Jason-sketch729/Janus-Controller-master/Images/JC20.01-Features.PNG

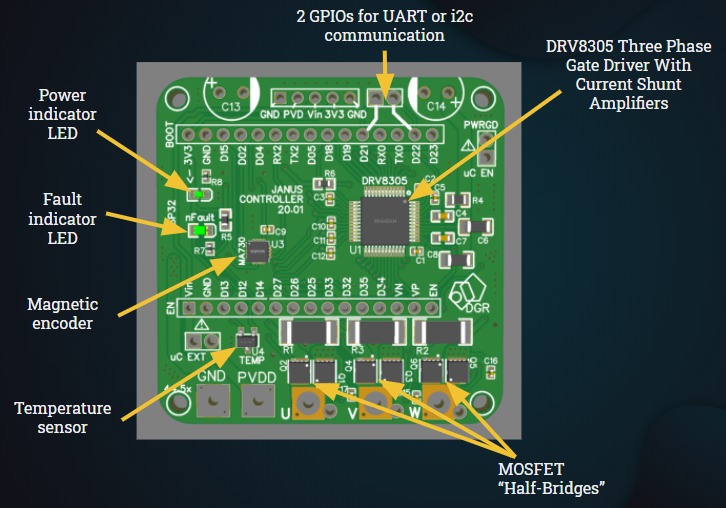
Images/JC20.01-Features.PNG
