Jason-sketch729/Janus-Controller-master/Images/AMT103.PNG

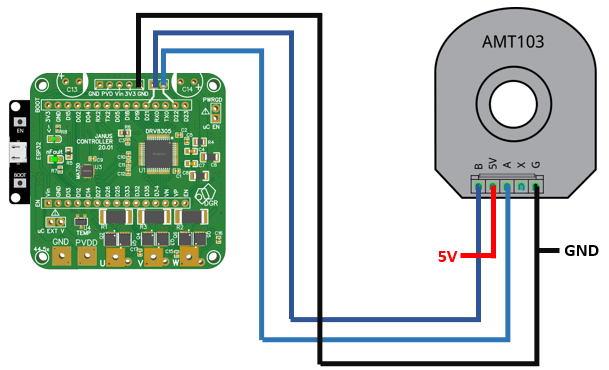
Images/AMT103.PNG
