Jason-sketch729/Janus-Controller-master/Images/BigJ-GIF.gif

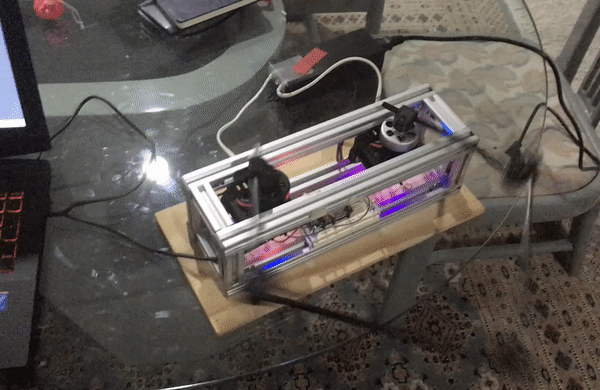
Images/BigJ-GIF.gif
