Jason-sketch729/Janus-Controller-master/Images/BigJ-iso.jpg

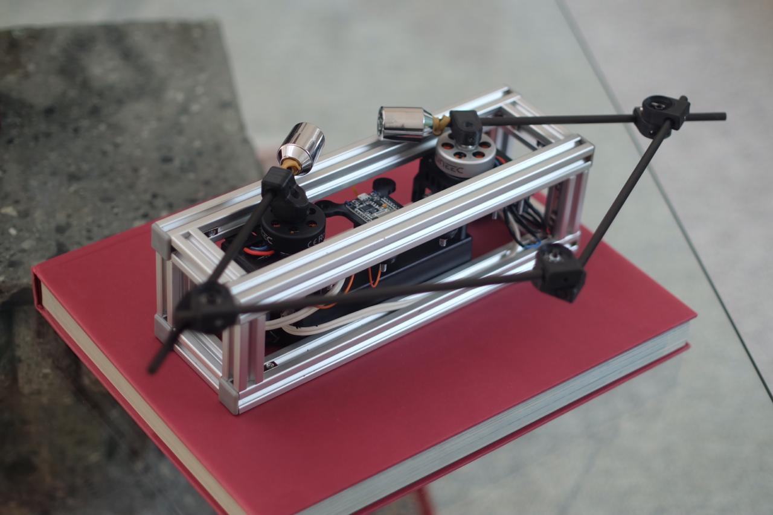
Images/BigJ-iso.jpg
