Jason-sketch729/Janus-Controller-master/Images/DRV8305Schematic.PNG

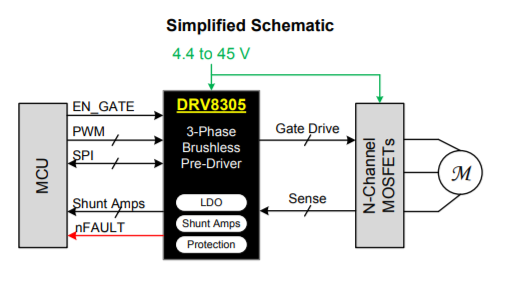
Images/DRV8305Schematic.PNG
