Jason-sketch729/Janus-Controller-master/Images/JC20.02.png

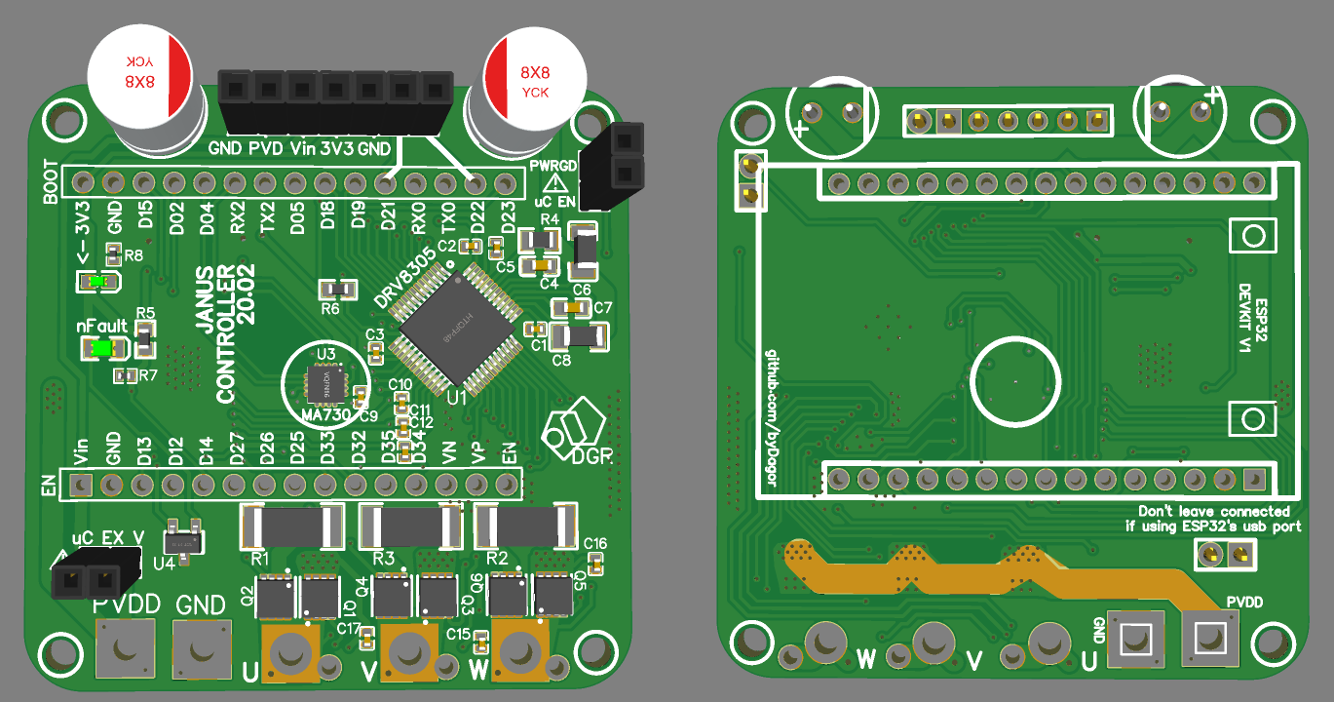
Images/JC20.02.png
