Jason-sketch729/Janus-Controller-master/Images/JCprep.PNG

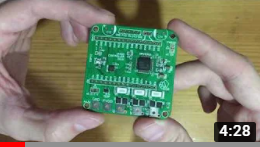
Images/JCprep.PNG
