Jason-sketch729/Janus-Controller-master/Images/LibraryManager.PNG

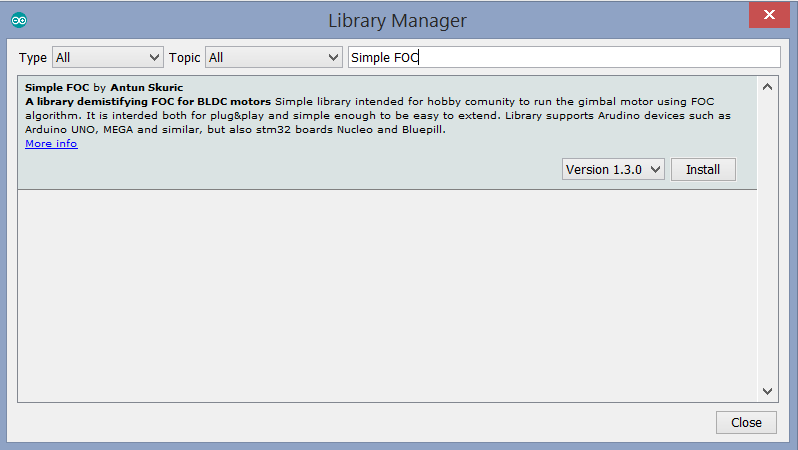
Images/LibraryManager.PNG
