Jason-sketch729/Janus-Controller-master/Images/MA730Magnet.PNG

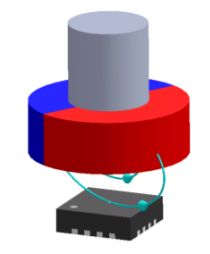
Images/MA730Magnet.PNG
