Jason-sketch729/Janus-Controller-master/JC20.01/Images/Back20.01.JPG

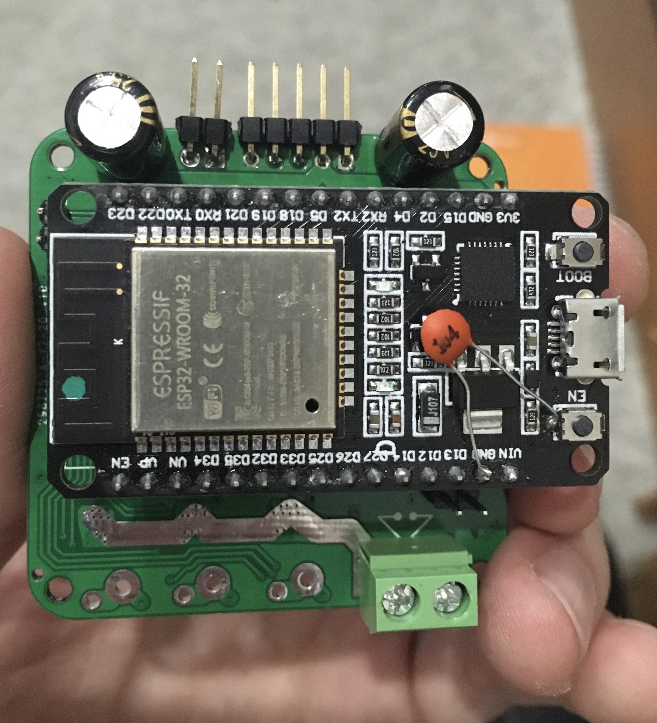
JC20.01/Images/Back20.01.JPG
