Jason-sketch729/Janus-Controller-master/JC20.01/Images/RenderFront20.01.PNG

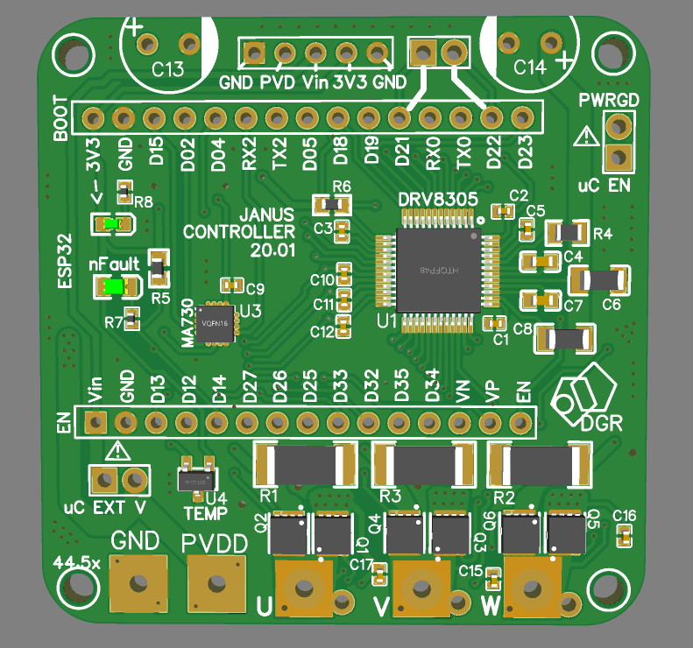
JC20.01/Images/RenderFront20.01.PNG
