Jason-sketch729/Janus-Controller-master/JC20.01/Schematics/JanusController20.01_Schematics.png

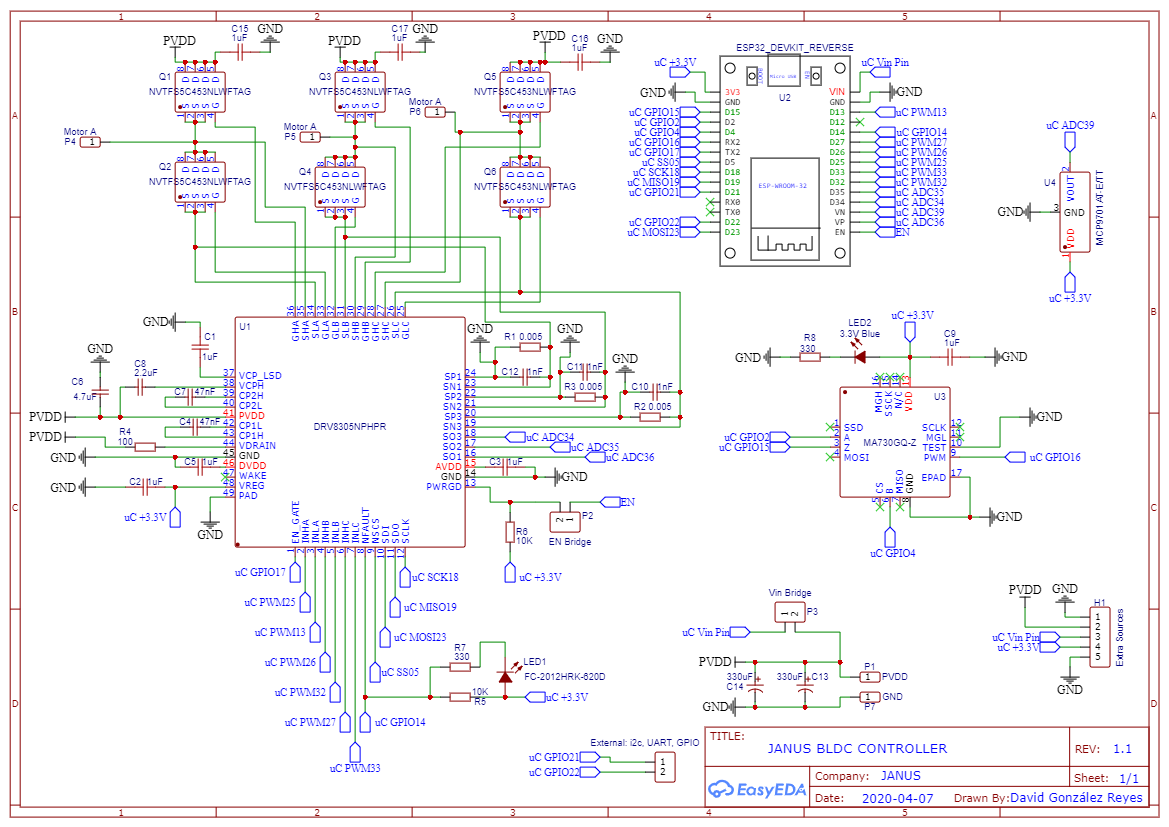
JC20.01/Schematics/JanusController20.01_Schematics.png
