Jason-sketch729/Janus-Controller-master/JC20.02/Images/JC20.02.png

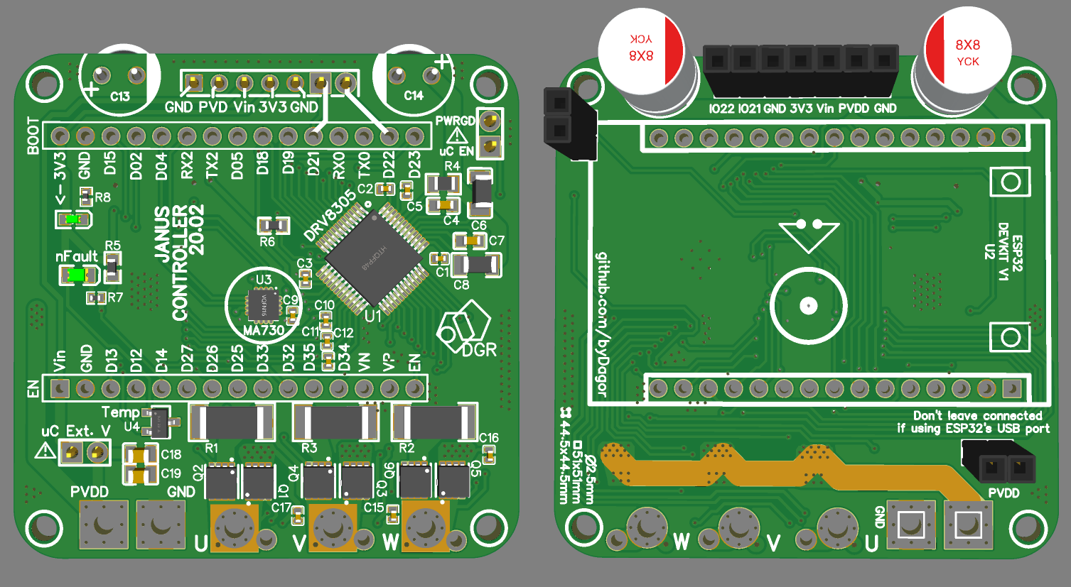
JC20.02/Images/JC20.02.png
