Jason-sketch729/Janus-Controller-master/JC20.02/BOM/BOM_through_hole_JC20.02.csv

ID | Name | Designator | Quantity
16 | 25V 470 uF Electrolytic Capacitor | C13,C14 | 2
17 | Femal pins |  | 30
18 | Male pins |  | 11
19 | Pin jumper |  | 2
20 | ESP32 DEVKIT |  | 1
21 | 2-pin screw terminal |  | 1
