Jason-sketch729/Janus-Controller-master/JC20.01/CAD/Test Station JC20.01.SLDASM

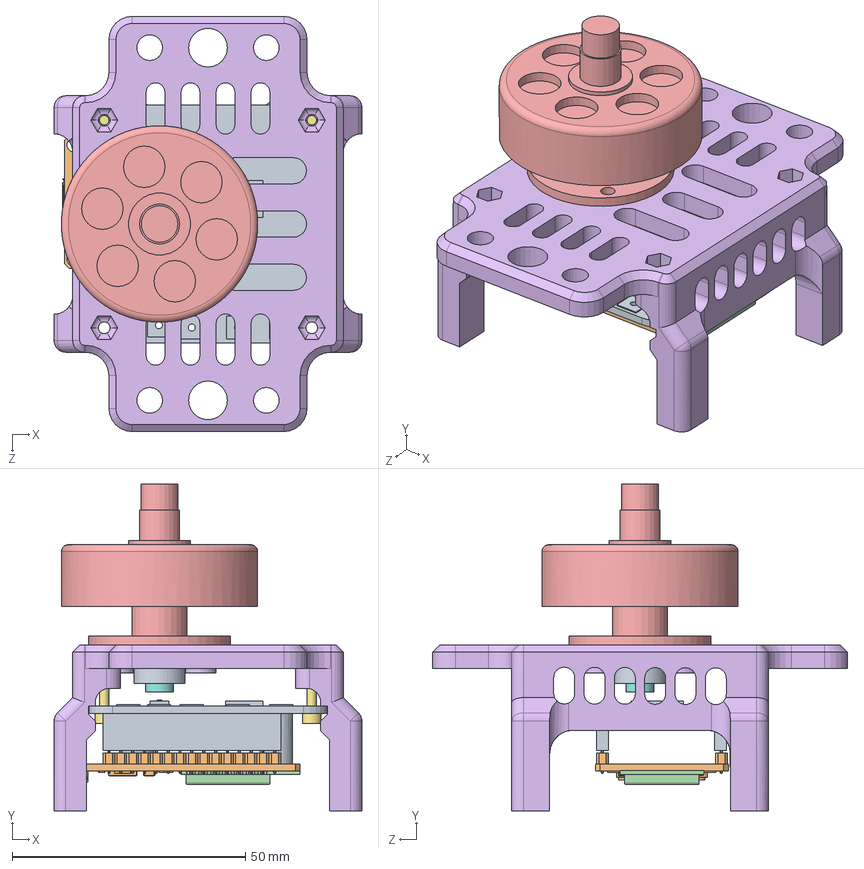
[picture p16: CAD file, 2016-09-20]
JC20.01/CAD/Test Station JC20.01.SLDASM
66.0 x 70.1 x 89.0 mm
PCB Janus Controller 20.01
6.ESP-32
Micro_USB
ESP-WROOM-32
YUNEEC YUMN4234 B
Test Station Base 012
Screw 2.5mm x 10mm x 2
Diametrical Magnet 6x6mm
Magnet Joint 012
