Jason-sketch729/Janus-Controller-master/JC20.01/CAD/ESP32_DevKit1.SLDASM

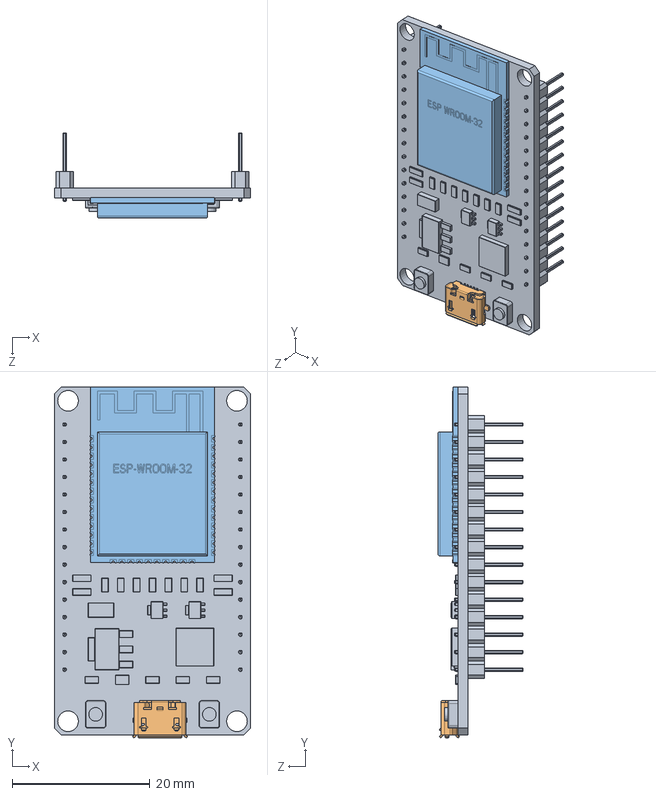
[picture p17: CAD file, 2016-09-08]
JC20.01/CAD/ESP32_DevKit1.SLDASM
28.5 x 50.9 x 12.4 mm
6.ESP-32
Micro_USB
ESP-WROOM-32
