Jason-sketch729/Janus-Controller-master/JC20.01/CAD/STL/Test Station JC20.01 - YUNEEC YUMN4234 B-1.STL

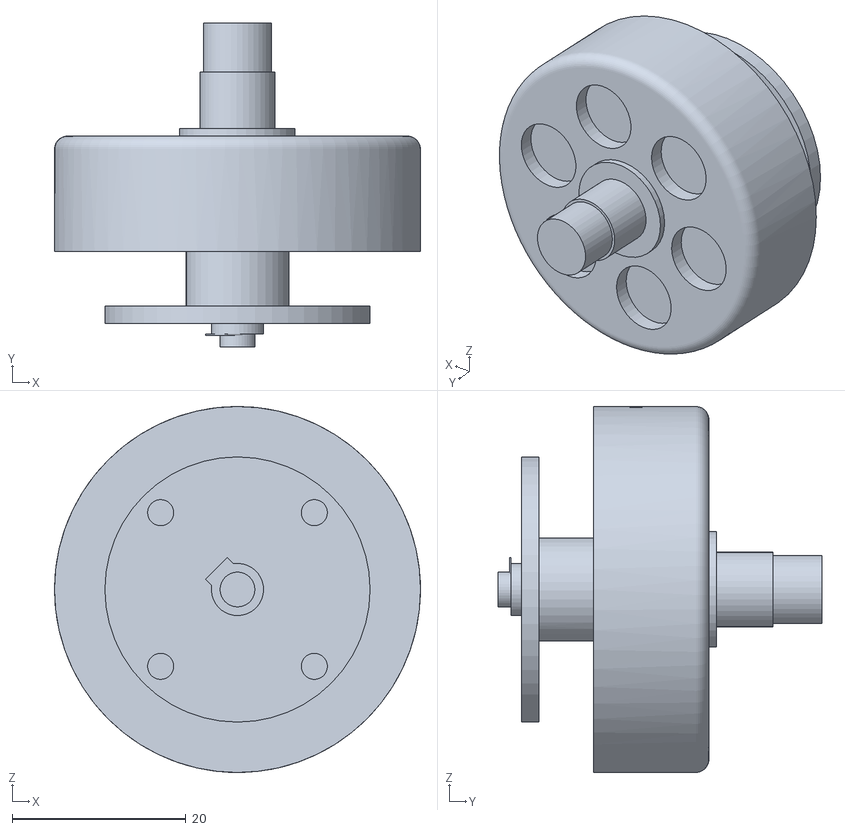
[picture p18: CAD file, 2016-09-20]
JC20.01/CAD/STL/Test Station JC20.01 - YUNEEC YUMN4234 B-1.STL
42.1 x 37.2 x 42.1
