Jason-sketch729/Janus-Controller-master/JC20.01/CAD/STL/Test Station JC20.01 - Test Station Base 012-2.STL

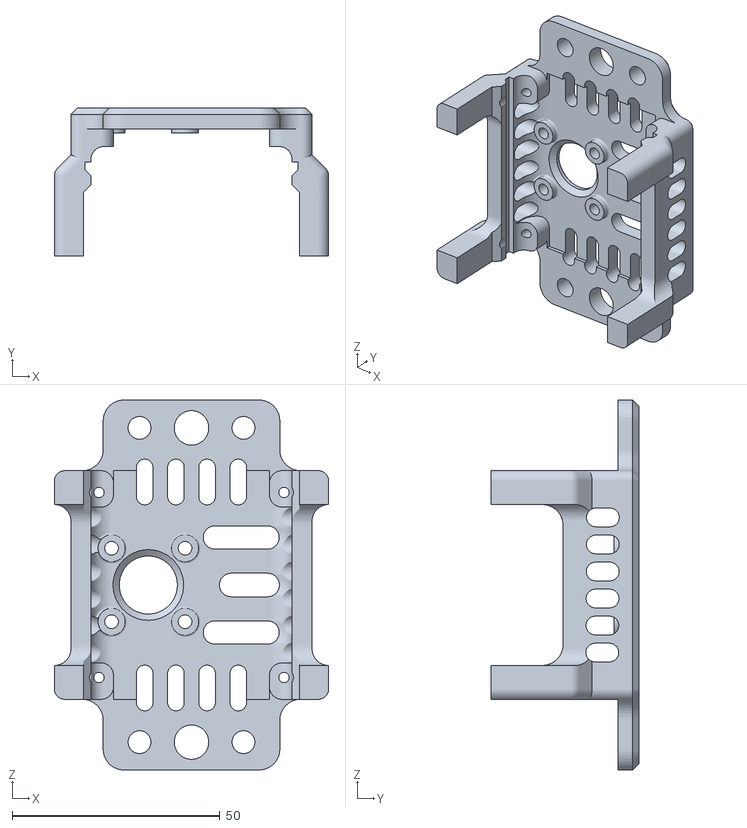
[picture p19: CAD file, 2016-09-20]
JC20.01/CAD/STL/Test Station JC20.01 - Test Station Base 012-2.STL
66.0 x 35.6 x 89.0
