Jason-sketch729/Janus-Controller-master/JC20.01/CAD/STL/Test Station JC20.01 - ESP32_DevKit1-1 ESP-WROOM-32-1.STL

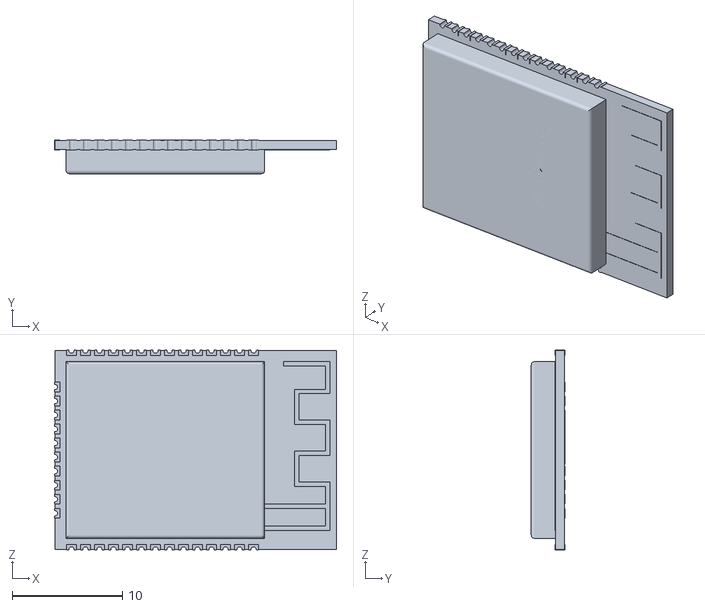
[picture p20: CAD file, 2016-09-18]
JC20.01/CAD/STL/Test Station JC20.01 - ESP32_DevKit1-1 ESP-WROOM-32-1.STL
25.5 x 3.04 x 18.1
