Jason-sketch729/Janus-Controller-master/JC20.01/CAD/PCB Janus Controller 20.01.SLDPRT

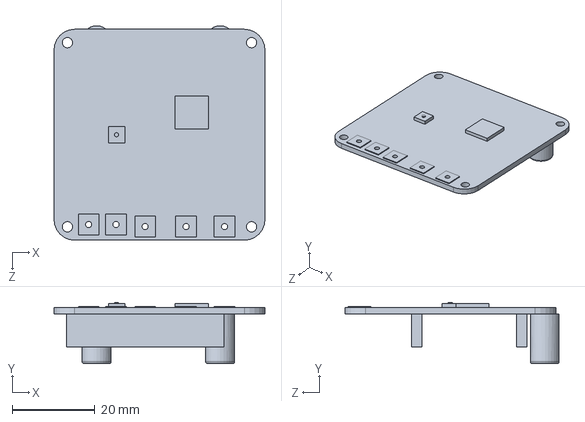
[picture p21: CAD file, 2016-09-09]
JC20.01/CAD/PCB Janus Controller 20.01.SLDPRT
51.0 x 14.9 x 51.8 mm
