Jason-sketch729/Janus-Controller-master/JC20.01/CAD/STL/Test Station JC20.01 - ESP32_DevKit1-1 6.ESP-32-1.STL

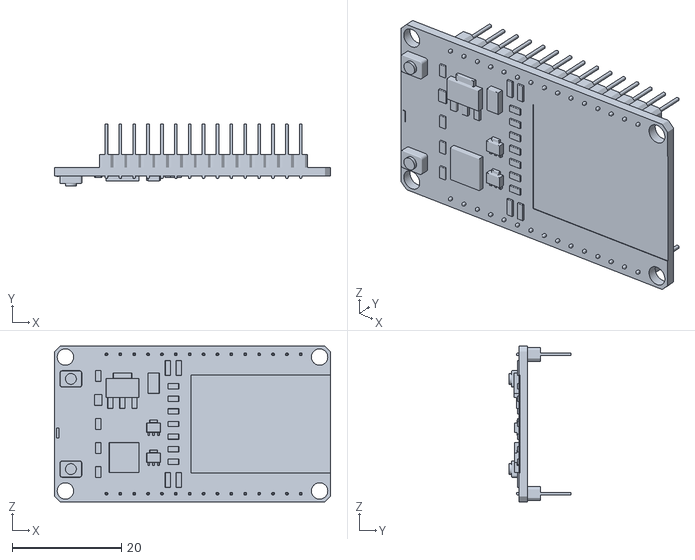
[picture p22: CAD file, 2016-09-18]
JC20.01/CAD/STL/Test Station JC20.01 - ESP32_DevKit1-1 6.ESP-32-1.STL
50.5 x 11.4 x 28.5
