Jason-sketch729/Janus-Controller-master/JC20.01/CAD/Magnet Joint 012.SLDPRT

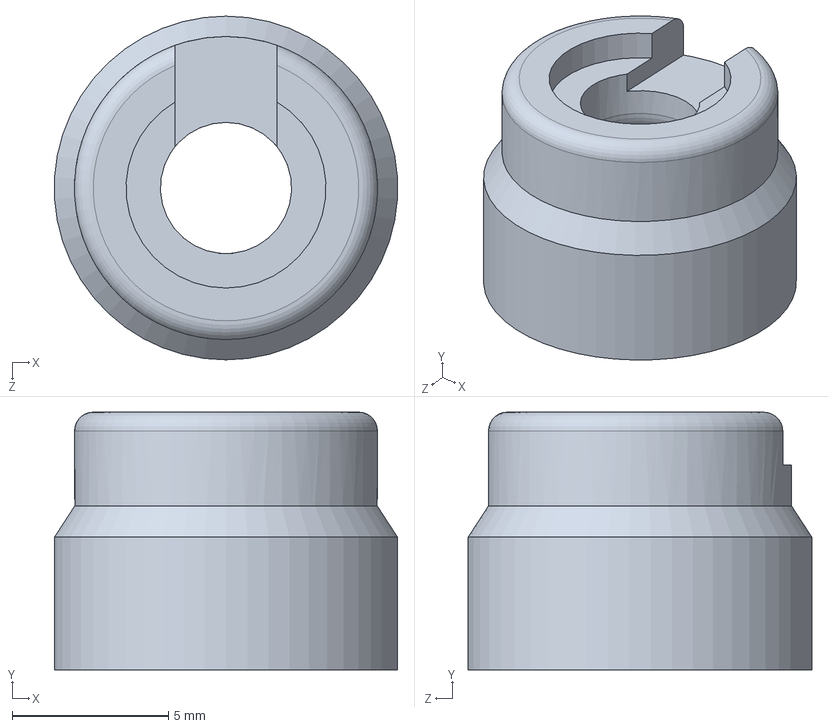
[picture p23: CAD file, 2016-09-09]
JC20.01/CAD/Magnet Joint 012.SLDPRT
11.0 x 8.25 x 11.0 mm
