Jason-sketch729/Janus-Controller-master/JC20.01/CAD/Micro_USB.SLDPRT

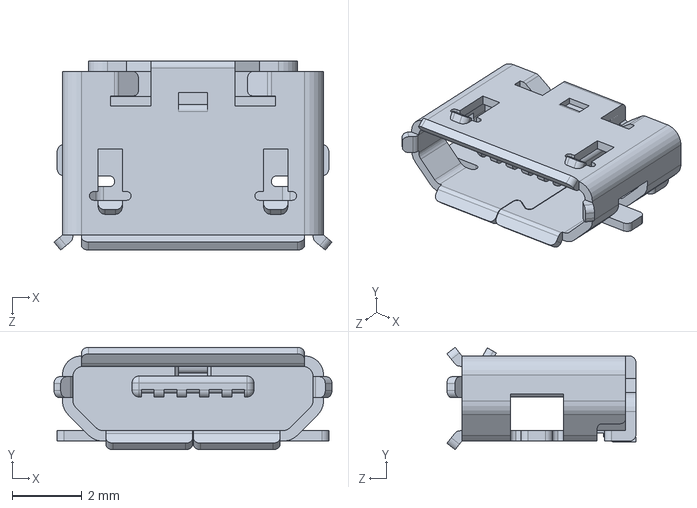
[picture p24: CAD file, 2016-09-09]
JC20.01/CAD/Micro_USB.SLDPRT
7.98 x 2.94 x 5.43 mm
