Jason-sketch729/Janus-Controller-master/JC20.01/CAD/STL/Test Station JC20.01 - Magnet Joint 012-1.STL

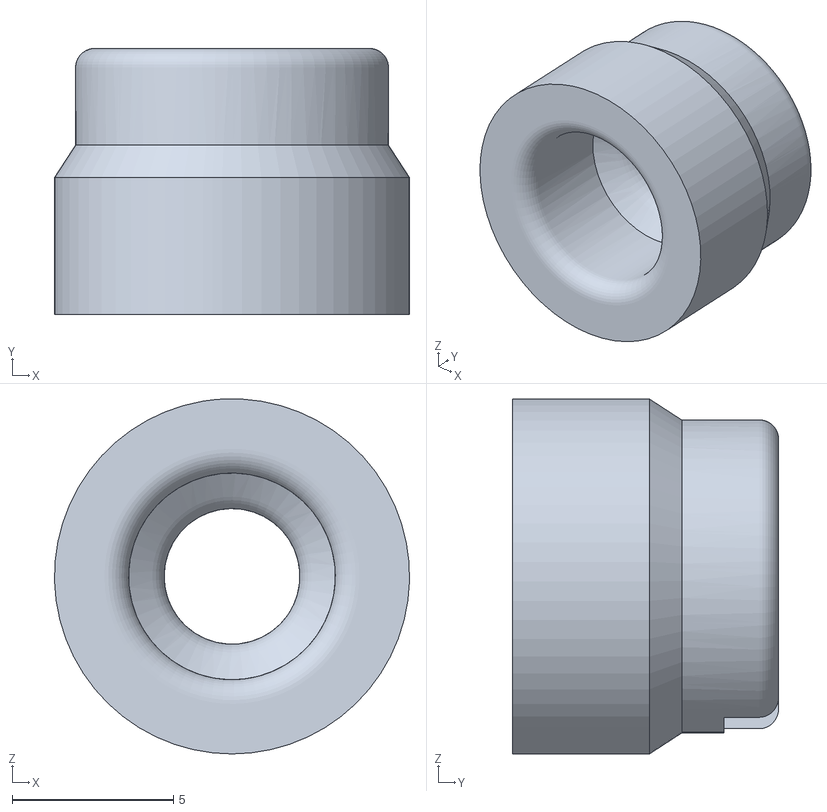
[picture p25: CAD file, 2016-09-18]
JC20.01/CAD/STL/Test Station JC20.01 - Magnet Joint 012-1.STL
11.0 x 8.25 x 11.0
