Jason-sketch729/Janus-Controller-master/JC20.01/CAD/6.ESP-32.SLDPRT

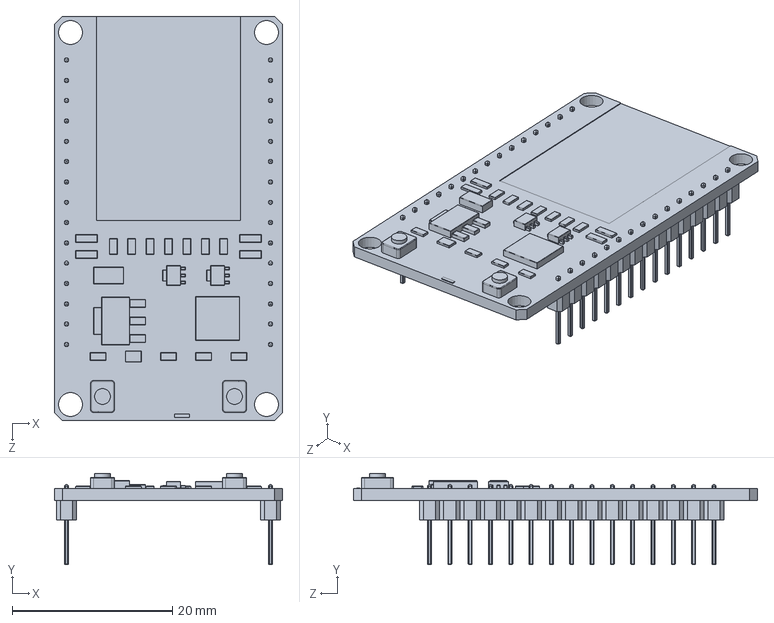
[picture p26: CAD file, 2016-09-08]
JC20.01/CAD/6.ESP-32.SLDPRT
28.5 x 11.4 x 50.5 mm
