Jason-sketch729/Janus-Controller-master/JC20.01/CAD/Diametrical Magnet 6x6mm.SLDPRT

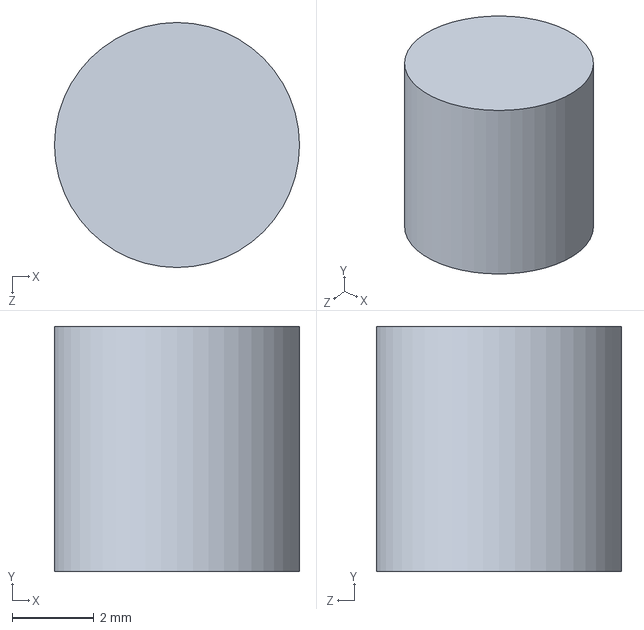
[picture p27: CAD file, 2016-09-08]
JC20.01/CAD/Diametrical Magnet 6x6mm.SLDPRT
6.00 x 6.00 x 6.00 mm
