Jason-sketch729/Janus-Controller-master/JC20.01/CAD/STL/ESP32_DevKit1 - 6.ESP-32-1.STL

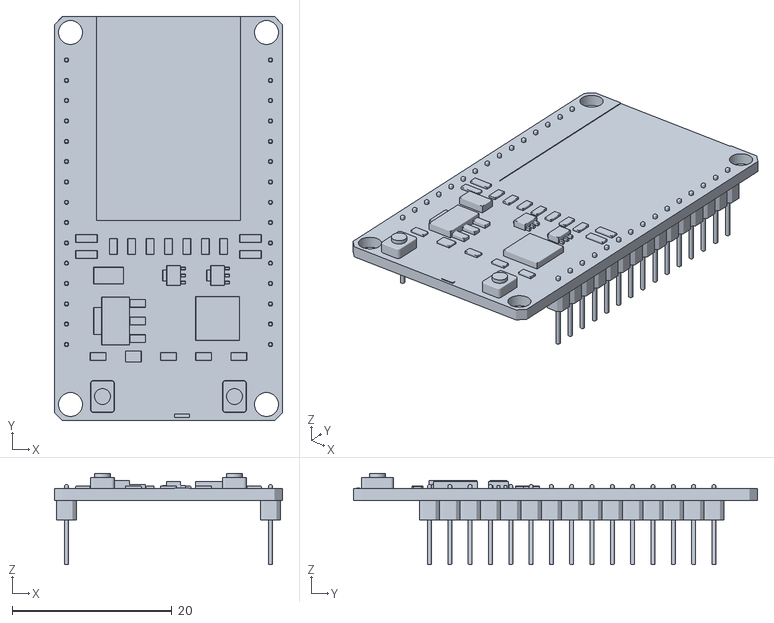
[picture p28: CAD file, 2016-09-09]
JC20.01/CAD/STL/ESP32_DevKit1 - 6.ESP-32-1.STL
28.5 x 50.5 x 11.4
