Jason-sketch729/Janus-Controller-master/(list of files, cad)

Other CAD files:
JC20.01/CAD/Test Station Base 012.SLDPRT
JC20.01/CAD/YUNEEC YUMN4234 B.SLDPRT
JC20.01/CAD/STL/Test Station JC20.01 - PCB Janus Controller 20.01-1.STL
JC20.01/CAD/STL/Test Station JC20.01 - ESP32_DevKit1-1 Micro_USB-1.STL
JC20.01/CAD/STL/Test Station JC20.01 - Diametrical Magnet 6x6mm-1.STL
JC20.01/CAD/ESP-WROOM-32.sldprt
JC20.01/CAD/STL/ESP32_DevKit1 - ESP-WROOM-32-1.STL
JC20.01/CAD/STL/ESP32_DevKit1 - Micro_USB-1.STL
JC20.01/CAD/STL/6.ESP-32.STL
JC20.01/CAD/STL/Diametrical Magnet 6x6mm.STL
JC20.01/CAD/STL/ESP-WROOM-32.STL
JC20.01/CAD/STL/Magnet Joint 012.STL
JC20.01/CAD/STL/Micro_USB.STL
JC20.01/CAD/STL/PCB Janus Controller 20.01.STL
JC20.01/CAD/STL/Test Station Base 012.STL
JC20.01/CAD/STL/Test Station JC20.01 - Screw 2.5mm x 10mm-1.STL
JC20.01/CAD/STL/Test Station JC20.01 - Screw 2.5mm x 10mm-2.STL
JC20.01/CAD/STL/YUNEEC YUMN4234 B.STL
JC20.01/CAD/Screw 2.5mm x 10mm.SLDPRT
