Jason-sketch729/Janus-Controller-master/(commit log)

2016-09-08 Add part 3 of 12
    [6.ESP-32.SLDPRT, BOM_SMD_JC20.01.csv, BOM_through_hole_JC20.01.csv, Diametrical Magnet 6x6mm.SLDPRT, ESP-WROOM-32.sldprt, ESP32_DevKit1.SLDASM]
2016-09-09 Add part 4 of 12
    [6.ESP-32.STL, Diametrical Magnet 6x6mm.STL, ESP-WROOM-32.STL, ESP32_DevKit1 - 6.ESP-32-1.STL, Magnet Joint 012.SLDPRT, Micro_USB.SLDPRT, PCB Janus Controller 20.01.SLDPRT]
2016-09-16 Add part 5 of 12
    [ESP32_DevKit1 - ESP-WROOM-32-1.STL, ESP32_DevKit1 - Micro_USB-1.STL, Magnet Joint 012.STL, Micro_USB.STL, PCB Janus Controller 20.01.STL, Test Station Base 012.STL, Test Station JC20.01 - Diametrical Magnet 6x6mm-1.STL]
2016-09-18 Add part 6 of 12
    [Test Station JC20.01 - ESP32_DevKit1-1 6.ESP-32-1.STL, Test Station JC20.01 - ESP32_DevKit1-1 ESP-WROOM-32-1.STL, Test Station JC20.01 - ESP32_DevKit1-1 Micro_USB-1.STL, Test Station JC20.01 - Magnet Joint 012-1.STL, Test Station JC20.01 - PCB Janus Controller 20.01-1.STL, Test Station JC20.01 - Screw 2.5mm x 10mm-1.STL, Test Station JC20.01 - Screw 2.5mm x 10mm-2.STL]
2016-09-20 Add part 7 of 12
    [Screw 2.5mm x 10mm.SLDPRT, Test Station Base 012.SLDPRT, Test Station JC20.01 - Test Station Base 012-2.STL, Test Station JC20.01 - YUNEEC YUMN4234 B-1.STL, Test Station JC20.01.SLDASM, YUNEEC YUMN4234 B.SLDPRT, YUNEEC YUMN4234 B.STL]
2016-09-22 Add part 8 of 12
    [Gerber_BoardOutline.GKO, Gerber_BottomLayer.GBL, Gerber_BottomSilkLayer.GBO, Gerber_BottomSolderMaskLayer.GBS, Gerber_Drill_NPTH.DRL, Gerber_Drill_PTH.DRL]
2016-09-23 Add part 9 of 12
    [Gerber_TopLayer.GTL, Gerber_TopPasteMaskLayer.GTP, Gerber_TopSilkLayer.GTO, Gerber_TopSolderMaskLayer.GTS]
2016-09-24 Add part 10 of 12
    [BOM_SMD_JC20.02.csv, BOM_through_hole_JC20.02.csv]
2016-09-27 Add part 11 of 12
    [Gerber_BoardOutline.GKO, Gerber_BottomLayer.GBL, Gerber_BottomSilkLayer.GBO, Gerber_BottomSolderMaskLayer.GBS, Gerber_Drill_NPTH.DRL, Gerber_Drill_PTH.DRL]
2016-09-29 Add part 12 of 12
    [PickAndPlace_JANUS_CONTROLLER_20.02.csv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]
